amselgesang/weatherframe_v01/raw/images/hat-back-ruler.jpg

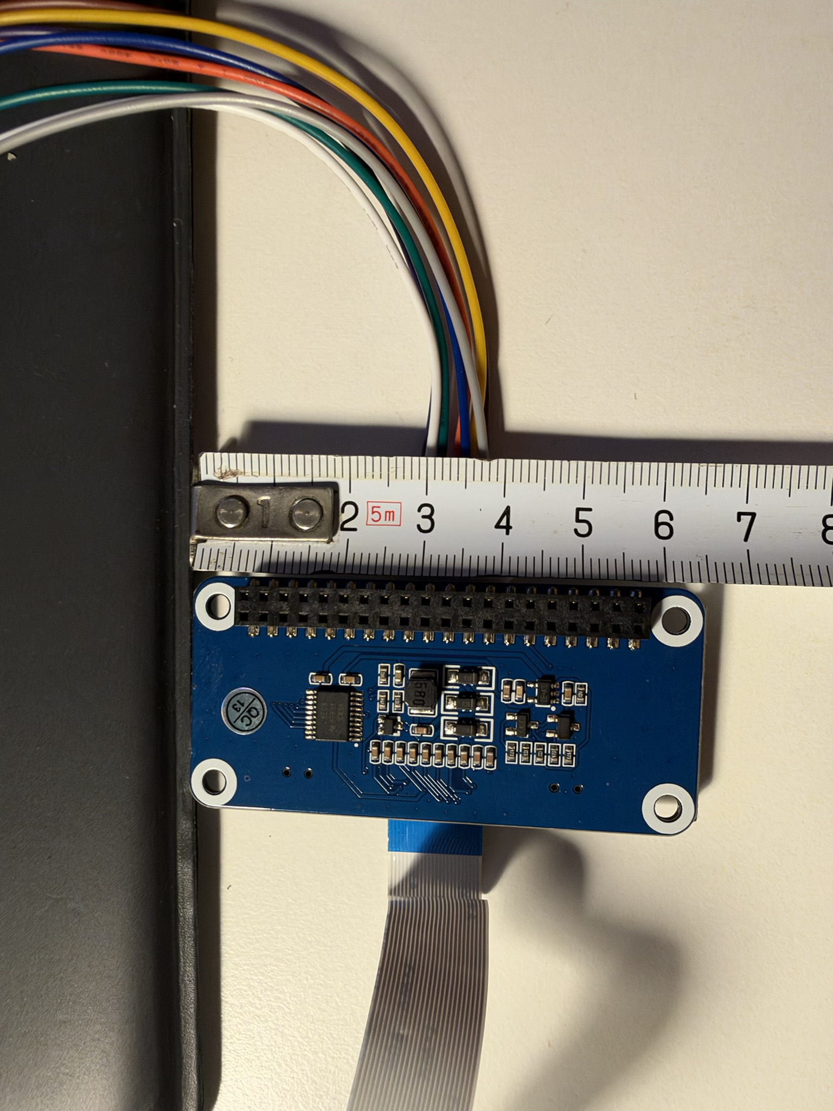
raw/images/hat-back-ruler.jpg
