amselgesang/weatherframe_v01/docs/images/weatherframe_cartoon.jpg

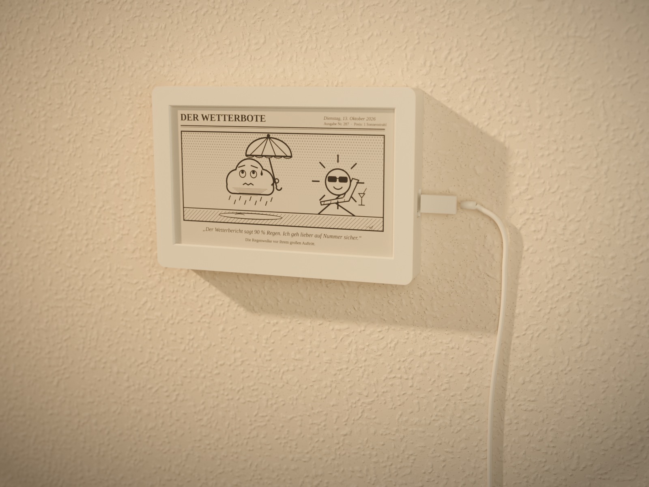
docs/images/weatherframe_cartoon.jpg
