amselgesang/weatherframe_v01/raw/README.md

# raw/ — immutable sources

Files here are kept exactly as received or clipped. The agent reads them and summarises them in
`wiki/sources/`, but never edits them. Add new material as new files.

| File | What | Date |
|---|---|---|
| `requirements-2026-10-13.md` | The project brief and later requirements, in the owner's words | 2026-10-13 |
| `images/hat-front.jpg`, `images/hat-back-ruler.jpg` | Photos of the Waveshare e-Paper Driver HAT Rev2.1, back side with a cm ruler | 2026-10-13 |
| `jlcpcb-assembly-message-2026-10-13.md` | JLCPCB's message refusing the ESP32 module in Economic assembly | 2026-10-13 |
| `seeed-gfx-epaper-board-pins.h` | Pin definitions for the XIAO ePaper boards, excerpt from Seeed_GFX (MIT) | 2026-10-13 |
| `waveshare-7in5-v2-mechanical.md` | Clipping of the panel's mechanical drawing (spec rev 2.0, section 1.4) | 2026-10-13 |
| `ti-tps63001-pins.md` | Clipping of the TPS63001 pin table used to verify the custom PCB | 2026-10-13 |
| `seeed-xiao-epaper-boards.md` | Clipping of Seeed's wiki pages for the EE04/EE05 boards | 2026-10-13 |
