amselgesang/weatherframe_v01/raw/requirements-2026-10-13.md

# Requirements as stated by the owner (verbatim, 2026-10-13)

> I would like to have a weather station using my waveshare 7.5 grayscale e-paper. I would like to use
> it as a picture frame on the wall. it connects to wifi but I would like to use it with chargeable
> battery. I need a design of the frame and the pcb as well. I have adobe fusion 365 for physical design
> and I have kicad for pcb design if needed. use them if possible

> also, eventually I want to use jclpcb to manufacture the pcb and the parts

> i would prefer a white frame color

> could the frame extended with a flip out stand so it can be also put to a cupboard
> → 25 degree and 3 mm gap

> can you engrave the text on the left side of those wholes. also make the hinge wider. it looks a bit unstable.
> use the right side of the whole for the refresh text

> can you make the stand wider

> unfortunatley I cannot solder  → chose: off-the-shelf ESP32 board
