amselgesang/weatherframe_v01/raw/waveshare-7in5-v2-mechanical.md

# Clipping: Waveshare 7.5inch e-Paper V2 Specification, rev 2.0 (2019-06-28), section 1.4

Source: https://files.waveshare.com/upload/6/60/7.5inch_e-Paper_V2_Specification.pdf (read 2026-10-13
through the Google Docs viewer; direct download was blocked by the network proxy).

- Outline 170.2 ± 0.2 × 111.2 ± 0.2 × 1.18 ± 0.1 mm; corners R1.
- Active area 163.2 ± 0.1 × 97.92 ± 0.1 mm; 800 × 480 px, 125 dpi, pixel 0.204 × 0.205 mm.
- Layer steps horizontal: AA 163.2 → FPL 164.8 → PS 167.8 → outline 170.2 (0.8 / 1.5 / 1.2 mm per side).
- Layer steps vertical: AA 97.92 → FPL 104.09 → PS 107.09 → outline 111.2.
- FPC: 24 pins, 0.5 mm pitch, 22.04 ± 0.1 mm wide, tail 24 ± 0.2 mm, leaves the long edge.
- Unlabelled tolerances ±0.15 mm.
- Grayscale: 4 levels (4-grey refresh about 2.1 s, from the Waveshare wiki); controller UC8179.
