amselgesang/weatherframe_v01/wiki/sources/requirements-2026-10-13.md

---
title: Owner requirements (2026-10-13)
type: source-summary
sources:
  - raw/requirements-2026-10-13.md
related:
  - "[[overview]]"
  - "[[flip-out-stand]]"
  - "[[no-solder-build]]"
created: 2026-10-13
updated: 2026-10-13
confidence: high
---
# Owner requirements (2026-10-13)

Weather station on the owner's [[waveshare-7in5-v2-panel]], used as a wall picture frame, Wi-Fi,
rechargeable battery; frame and PCB to be designed, in Fusion 360 and KiCad where possible; made by
[[jlcpcb]]. Later: white frame, [[flip-out-stand]] at 25° with a 3 mm wall gap, engraved button labels,
wider hinge and stand, and no soldering ([[no-solder-build]]).
