amselgesang/weatherframe_v01/wiki/sources/seeed-gfx-epaper-board-pins.md

---
title: Seeed_GFX board pin definitions
type: source-summary
sources:
  - raw/seeed-gfx-epaper-board-pins.h
related:
  - "[[seeed-ee05]]"
  - "[[esphome-firmware]]"
created: 2026-10-13
updated: 2026-10-13
confidence: high
---
# Seeed_GFX board pin definitions

`User_Setups/EPaper_Board_Pins_Setups.h` from Seeed_GFX (MIT): SPI, CS, DC, BUSY, RST and
`TFT_ENABLE` (panel power, GPIO43, driven HIGH) for the EE02–EE05 and EN04/EN05 boards. Authoritative
source for the [[seeed-ee05]] panel pins in the [[esphome-firmware]].
