amselgesang/weatherframe_v01/wiki/sources/seeed-xiao-epaper-boards.md

---
title: Seeed XIAO ePaper board docs
type: source-summary
sources:
  - raw/seeed-xiao-epaper-boards.md
related:
  - "[[seeed-ee05]]"
  - "[[custom-pcb-vs-ee05]]"
created: 2026-10-13
updated: 2026-10-13
confidence: medium
---
# Seeed XIAO ePaper board docs

Wiki and shop pages for EE04/EE05/EN04/EN05 and the ESPHome cookbook: board features, supported
panels, EE04 battery and key pins, ESPHome display pins. Basis for choosing the [[seeed-ee05]];
EN0x boards ruled out (no Wi-Fi). Battery/key pins for the EE05 itself are not documented
(confidence medium).
