amselgesang/weatherframe_v01/wiki/sources/waveshare-7in5-v2-mechanical.md

---
title: Waveshare 7.5" V2 mechanical drawing
type: source-summary
sources:
  - raw/waveshare-7in5-v2-mechanical.md
related:
  - "[[waveshare-7in5-v2-panel]]"
  - "[[frame]]"
created: 2026-10-13
updated: 2026-10-13
confidence: high
---
# Waveshare 7.5" V2 mechanical drawing

Outline, active area, layer steps and FPC data for the [[waveshare-7in5-v2-panel]]; the basis for the
window, recess and ribbon routing of the [[frame]].
