amselgesang/weatherframe_v01/wiki/entities/jlcpcb.md

---
title: JLCPCB / JLC3DP
type: entity
sources:
  - raw/jlcpcb-assembly-message-2026-10-13.md
related:
  - "[[jlc-assembly-tiers]]"
  - "[[frame]]"
created: 2026-10-13
updated: 2026-10-13
confidence: high
---
# JLCPCB / JLC3DP

Manufacturer chosen by the owner. PCB fabrication + SMT assembly (JLCPCB) and 3D printing (JLC3DP).
Assembly tiers matter: see [[jlc-assembly-tiers]]. Current plan: only the [[frame]] is ordered here
(MJF PA12 or SLA 9000R, white); electronics are bought ready-made ([[seeed-ee05]]).

Sources: [[jlcpcb-assembly-message]]
