amselgesang/weatherframe_v01/wiki/sources/hat-photos.md

---
title: HAT photos with ruler
type: source-summary
sources:
  - raw/images/hat-front.jpg
  - raw/images/hat-back-ruler.jpg
related:
  - "[[waveshare-epaper-driver-hat]]"
  - "[[frame]]"
created: 2026-10-13
updated: 2026-10-13
confidence: high
---
# HAT photos with ruler

Two photos of the [[waveshare-epaper-driver-hat]] Rev2.1: front (labels, switches, ZIF, JST PH) and
back with a cm ruler (65 mm width, 40-pin header along the edge opposite the ribbon, four mounting holes).
Used to replace the assumed HAT mount with four standoffs in the [[frame]].
