amselgesang/weatherframe_v01/wiki/sources/ti-tps63001-pins.md

---
title: TI TPS63001 pin table
type: source-summary
sources:
  - raw/ti-tps63001-pins.md
related:
  - "[[custom-pcb-r1]]"
created: 2026-10-13
updated: 2026-10-13
confidence: high
---
# TI TPS63001 pin table

Used to verify the buck-boost wiring of the [[custom-pcb-r1]]: FB must go to VOUT on fixed versions,
PS/SYNC low enables power-save mode. All ten pins matched.
