amselgesang/weatherframe_v01/docs/images/screen_cartoon.png

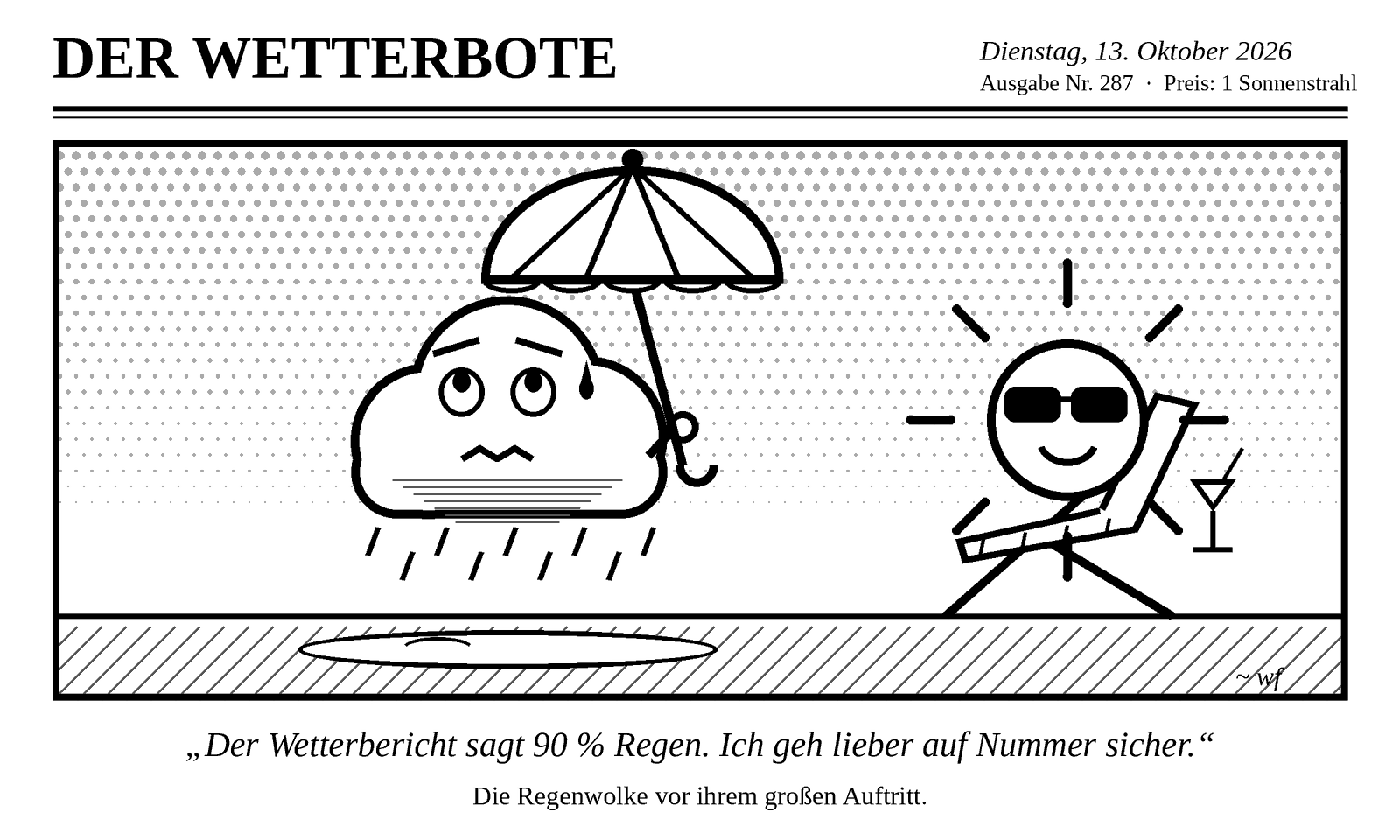
docs/images/screen_cartoon.png
