amselgesang/weatherframe_v01/docs/images/screen_forecast.png

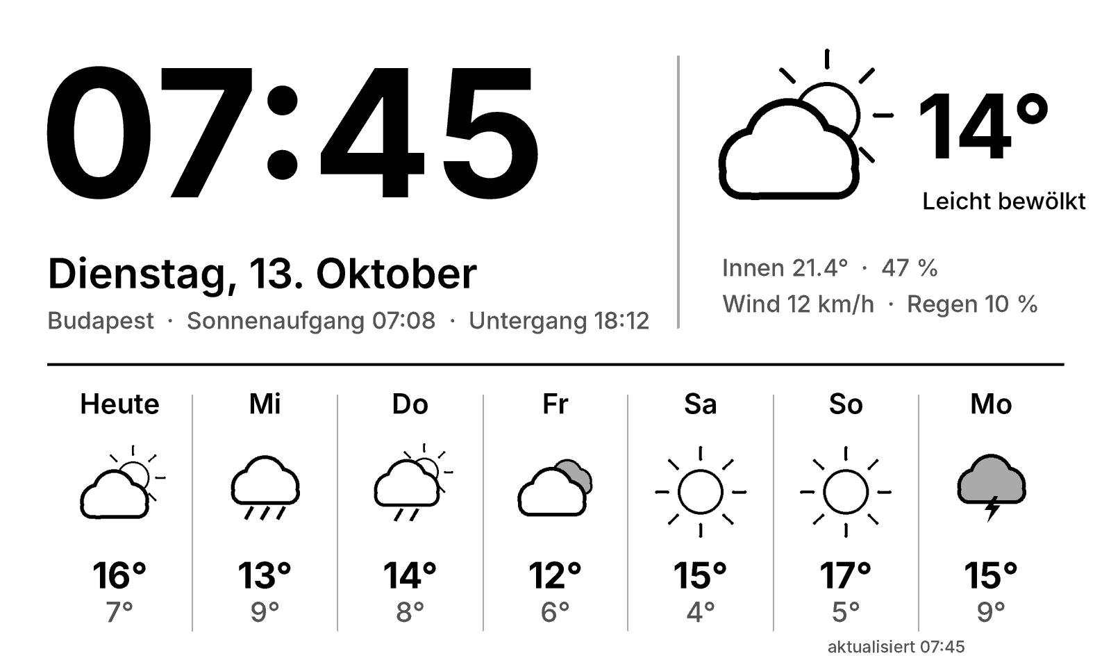
docs/images/screen_forecast.png
