amselgesang/weatherframe_v01/hardware/mechanical/export/view_bezel_inside.png

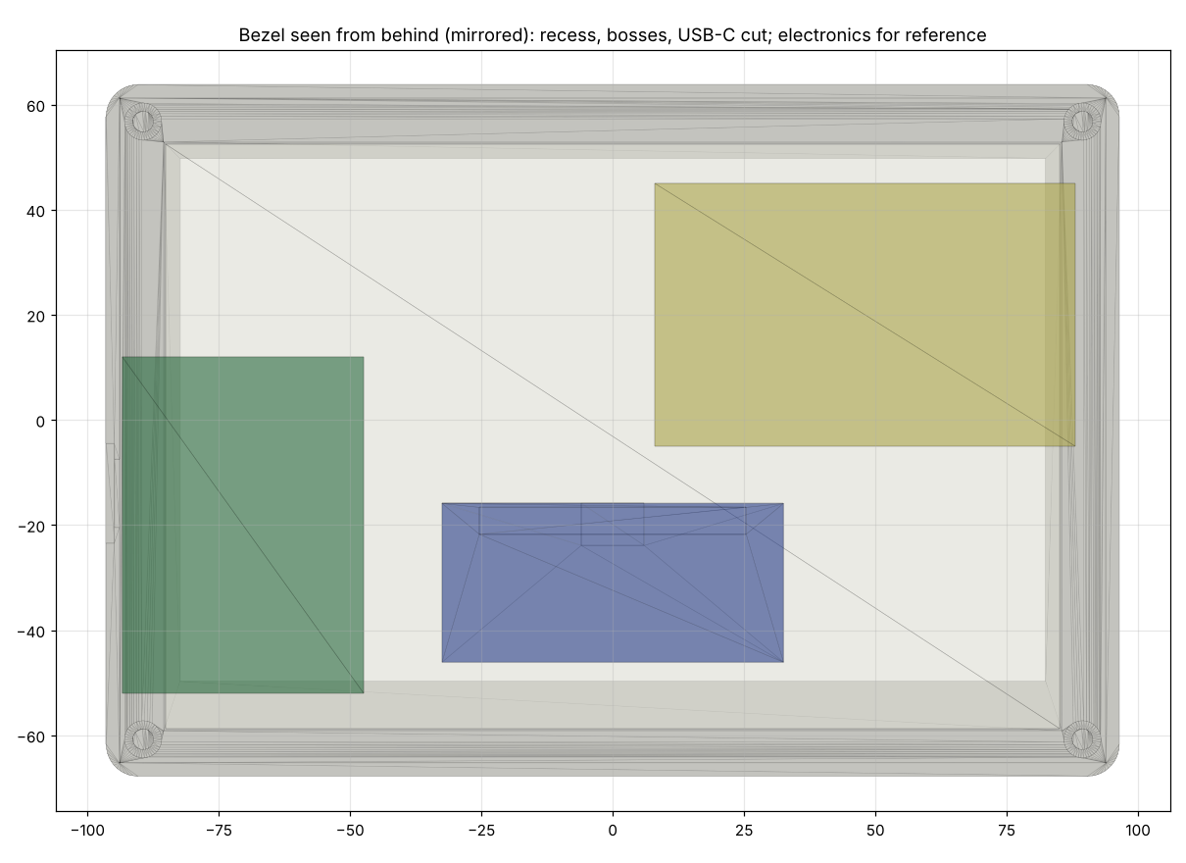
hardware/mechanical/export/view_bezel_inside.png
