amselgesang/weatherframe_v01/hardware/mechanical/export/view_front.png

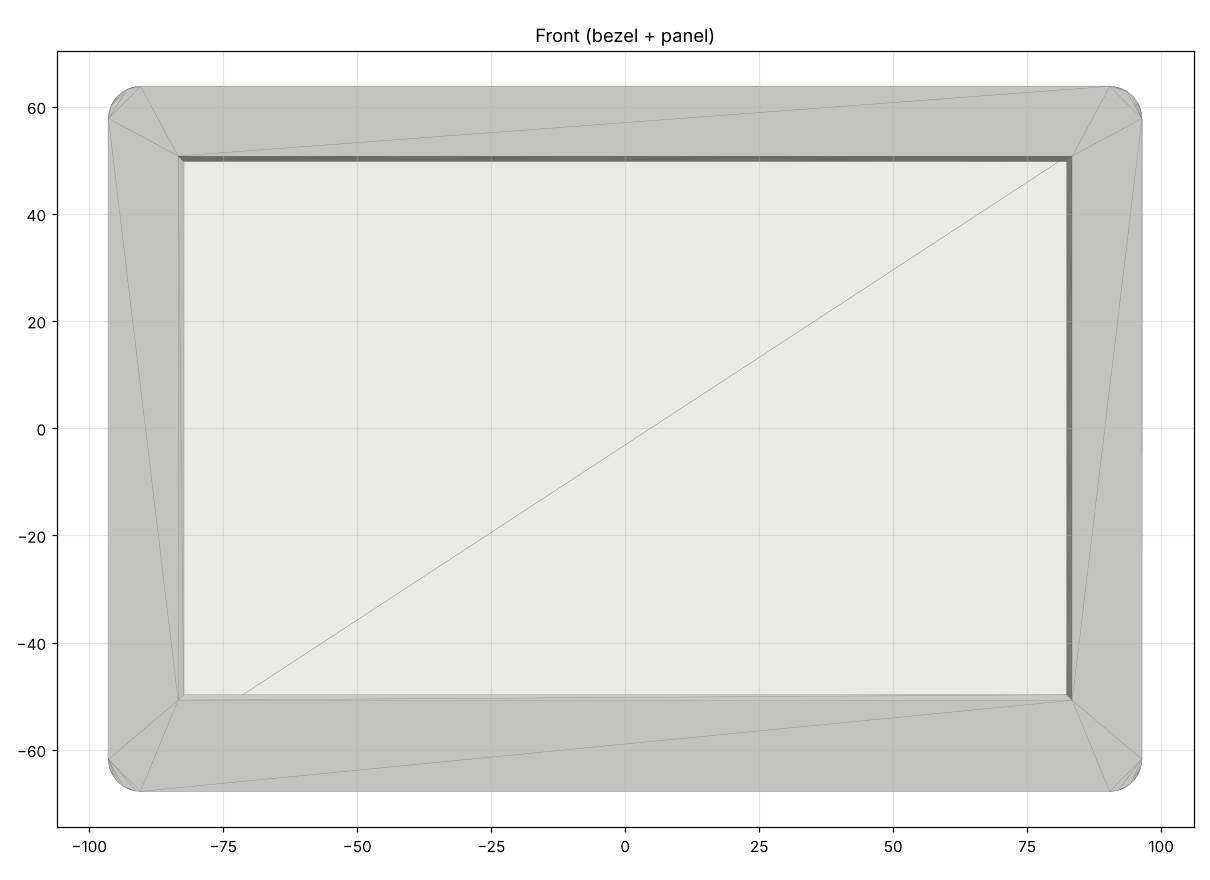
hardware/mechanical/export/view_front.png
