amselgesang/weatherframe_v01/hardware/mechanical/export/view_inside_back.png

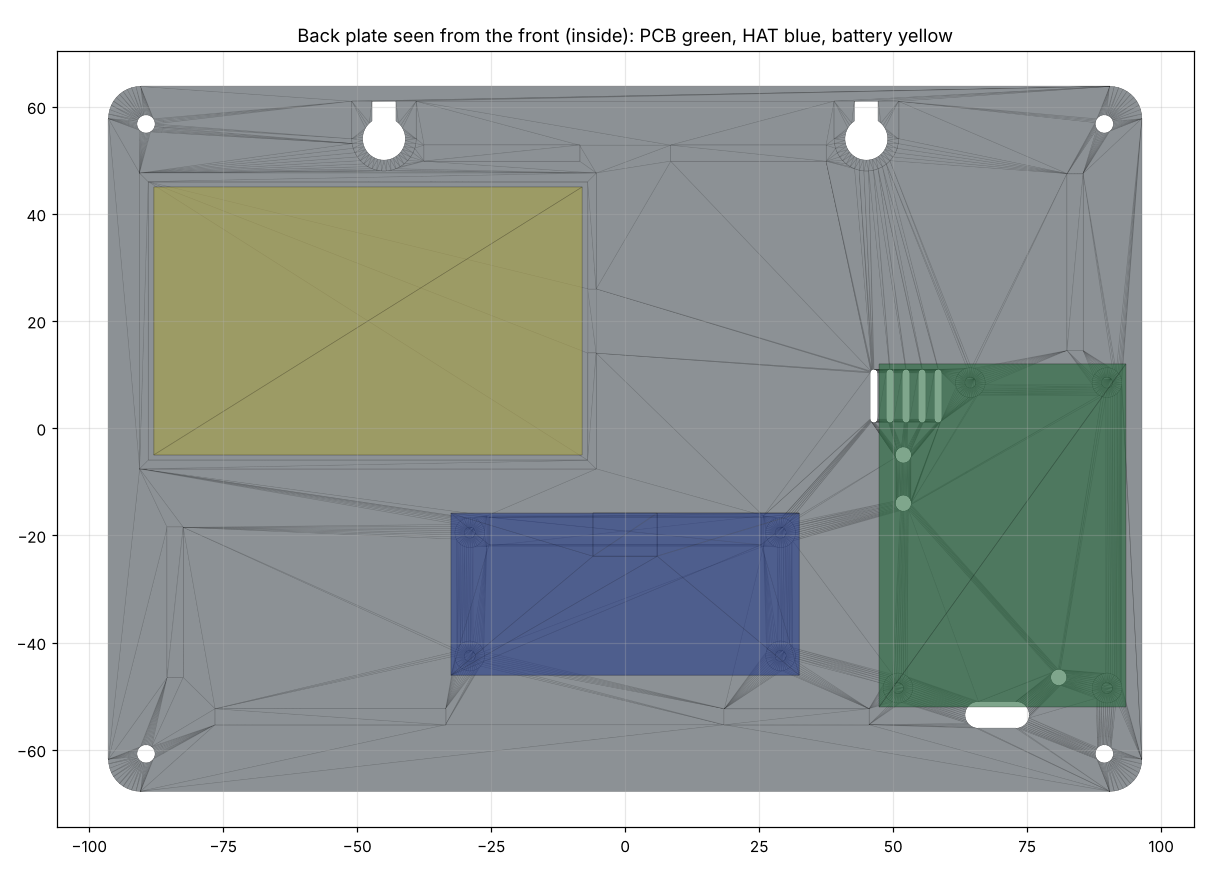
hardware/mechanical/export/view_inside_back.png
