amselgesang/weatherframe_v01/hardware/mechanical/export/view_rear.png

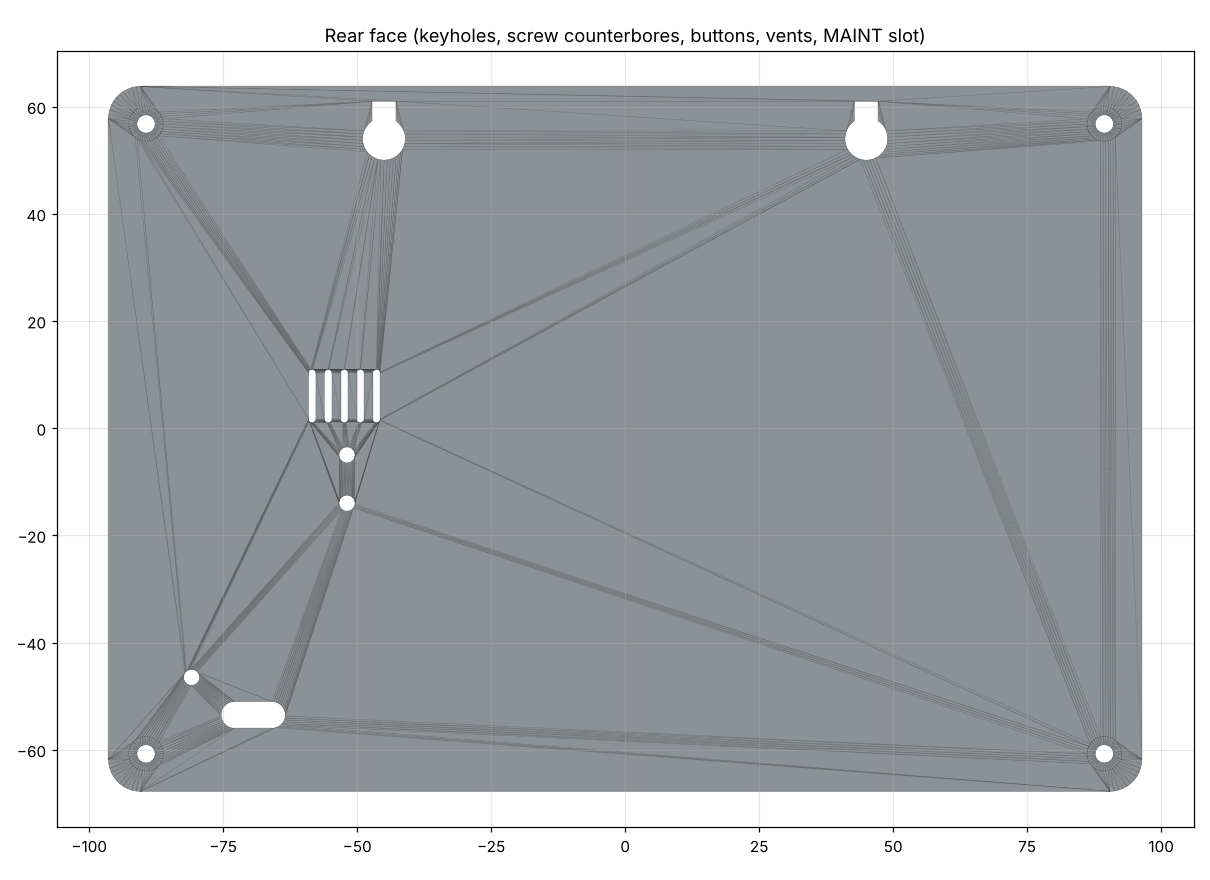
hardware/mechanical/export/view_rear.png
