amselgesang/weatherframe_v01/raw/images/hat-front.jpg

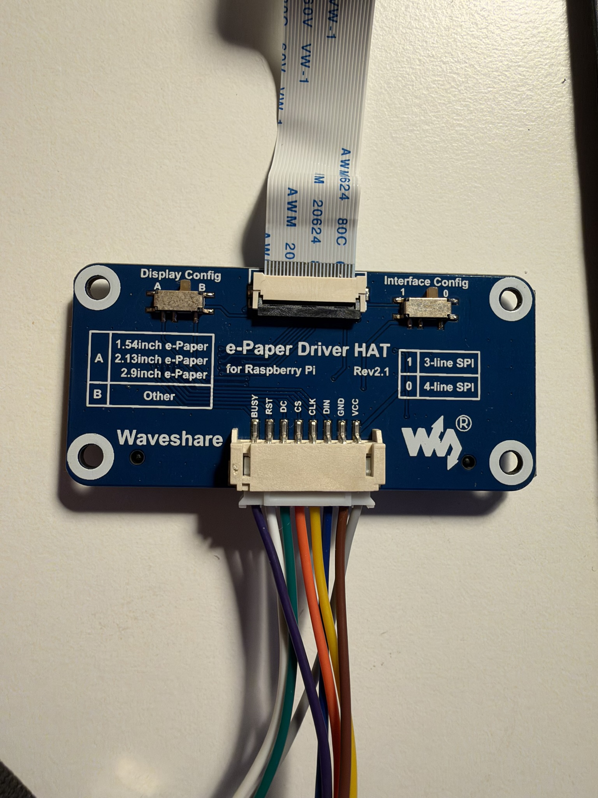
raw/images/hat-front.jpg
