amselgesang/weatherframe_v01/hardware/kicad/weatherframe/fab/bom_jlc.csv

Comment | Designator | Footprint | LCSC Part #
USB-C | J1 | USB_C_Receptacle_HRO_TYPE-C-31-M-12 | C165948
5.1k | R1,R2 | R_0402_1005Metric | C25905
USBLC6-2SC6 | U5 | SOT-23-6 | C7519
MCP73831-2 | U2 | SOT-23-5 | C424093
4.7uF | C1,C2,C13 | C_0603_1608Metric | C19666
2k | R3 | R_0402_1005Metric | C4109
1k | R4 | R_0402_1005Metric | C11702
CHG | D2 | LED_0603_1608Metric | C2286
100k | R5,R10,R17 | R_0402_1005Metric | C25741
150k | R6,R11 | R_0402_1005Metric | C25755
LiPo 1S | J2 | JST_PH_S2B-PH-SM4-TB_1x02-1MP_P2.00mm_Horizontal | C2763693
B5819W | D1 | D_SOD-123 | C8598
AO3401A | Q1,Q2 | SOT-23 | C15127
1M | R8,R9 | R_0402_1005Metric | C26083
100nF | C3,C5,C9,C11,C12 | C_0402_1005Metric | C1525
TPS63001 | U3 | Texas_DRC0010J | C28060
1.5uH | L1 | L_Changjiang_FNR4030S | C42100
10uF | C4 | C_0805_2012Metric | C15850
22uF | C6,C7 | C_0805_2012Metric | C45783
ESP32-S3-WROOM-1-N16R8 | U1 | ESP32-S3-WROOM-1 | C2913202
10uF | C8 | C_0603_1608Metric | C19702
10k | R12,R13,R14 | R_0402_1005Metric | C25744
1uF | C10 | C_0402_1005Metric | C52923
RESET | SW1 | SW_Push_1P1T_XKB_TS-1187A | C318884
BOOT | SW2 | SW_Push_1P1T_XKB_TS-1187A | C318884
REFRESH | SW3 | SW_Push_1P1T_XKB_TS-1187A | C318884
MAINT | SW4 | SW_SPDT_Shouhan_MSK12C02 | C431540
SHT40-AD1B | U4 | Sensirion_DFN-4_1.5x1.5mm_P0.8mm_SHT4x_NoCentralPad | C2909890
4.7k | R15,R16 | R_0402_1005Metric | C25900
