amselgesang/weatherframe_v01/hardware/mechanical/export/weatherframe_assembly.step

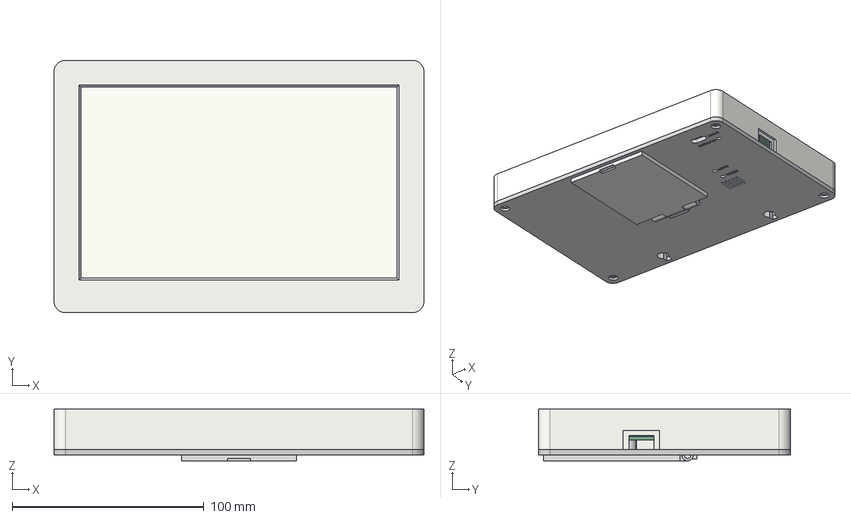
[picture p10: CAD file, 2026-10-13]
hardware/mechanical/export/weatherframe_assembly.step
192.8 x 131.5 x 27.0 mm
bezel
back
stand
ref_panel
ref_pcb
ref_hat
ref_battery
