amselgesang/weatherframe_v01/hardware/mechanical/export/back.step

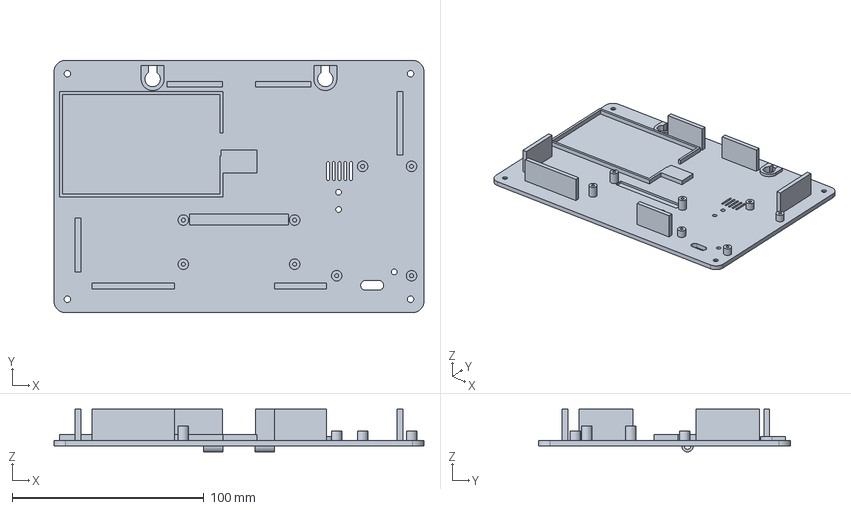
[picture p11: CAD file, 2026-10-13]
hardware/mechanical/export/back.step
192.8 x 131.5 x 22.3 mm
