amselgesang/weatherframe_v01/hardware/mechanical/export/bezel.step

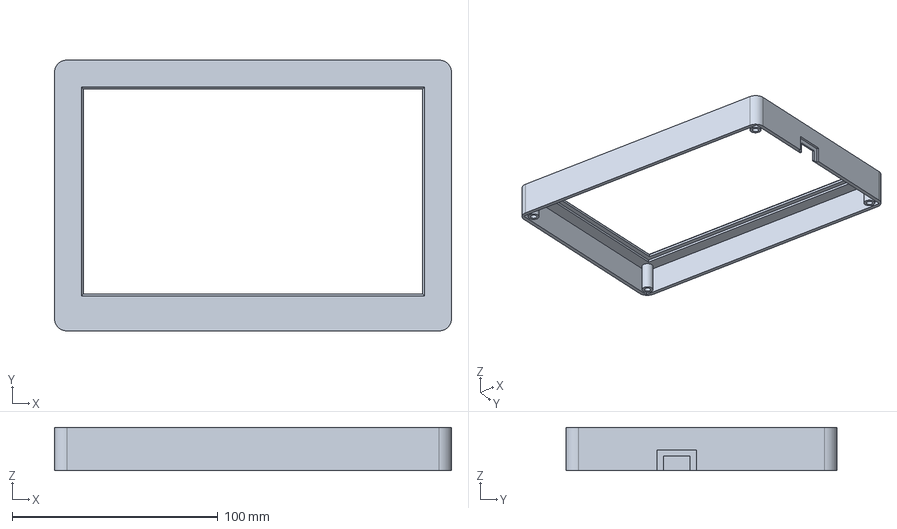
[picture p12: CAD file, 2026-10-13]
hardware/mechanical/export/bezel.step
192.8 x 131.5 x 21.0 mm
