amselgesang/weatherframe_v01/hardware/mechanical/export/stand.step

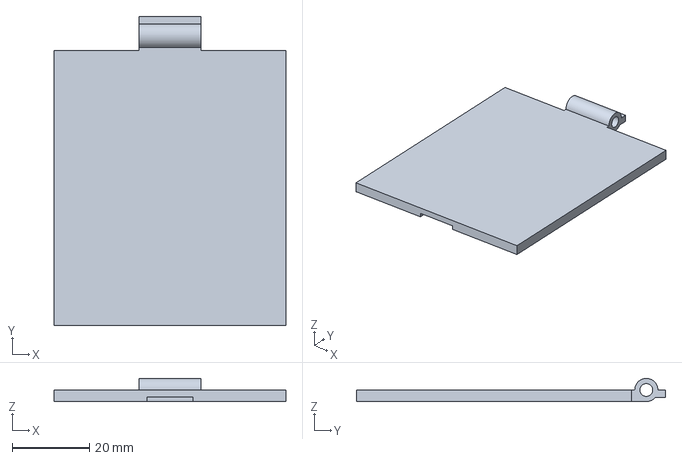
[picture p13: CAD file, 2026-10-13]
hardware/mechanical/export/stand.step
60.0 x 80.0 x 6.00 mm
