amselgesang/weatherframe_v01/(list of files, cad)

Other CAD files:
hardware/mechanical/export/back.stl
hardware/mechanical/export/bezel.stl
hardware/mechanical/export/stand.stl
