amselgesang/weatherframe_v01/raw/jlcpcb-assembly-message-2026-10-13.md

# JLCPCB assembly message for U1 (ESP32-S3-WROOM-1-N16R8), received 2026-10-13 (verbatim)

> Due to limits in package (0201), temperature and other certain conditions, this part is only available
> for Standard PCBA service. Economic PCBA has been chosen. If you want to place this part, please switch
> to the Standard PCBA.
> Note: The setup fee is $25 per assembly side for Standard PCBA.
> The board size is modified to be 74mm*70mm as for Standard PCBA each side should be longer than 70mm and
> the edge rails should be added.
