amselgesang/weatherframe_v01/wiki/sources/jlcpcb-assembly-message.md

---
title: JLCPCB assembly message
type: source-summary
sources:
  - raw/jlcpcb-assembly-message-2026-10-13.md
related:
  - "[[jlc-assembly-tiers]]"
  - "[[custom-pcb-vs-ee05]]"
created: 2026-10-13
updated: 2026-10-13
confidence: high
---
# JLCPCB assembly message

JLCPCB refused U1 (ESP32-S3-WROOM-1) in Economic assembly and proposed Standard assembly ($25 setup,
board enlarged to 74 × 70 mm with rails). Triggered [[custom-pcb-vs-ee05]]; background in
[[jlc-assembly-tiers]].
