amselgesang/weatherframe_v01/hardware/kicad/weatherframe/build/bcu.svg.png

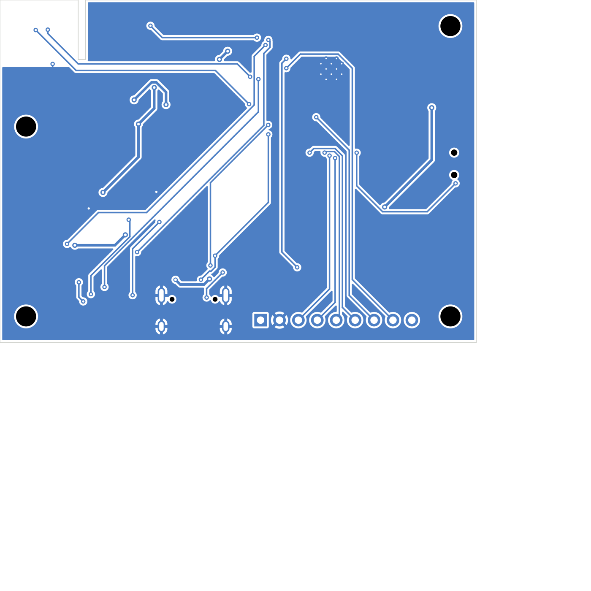
hardware/kicad/weatherframe/build/bcu.svg.png
