amselgesang/weatherframe_v01/hardware/kicad/weatherframe/build/fcu.svg.png

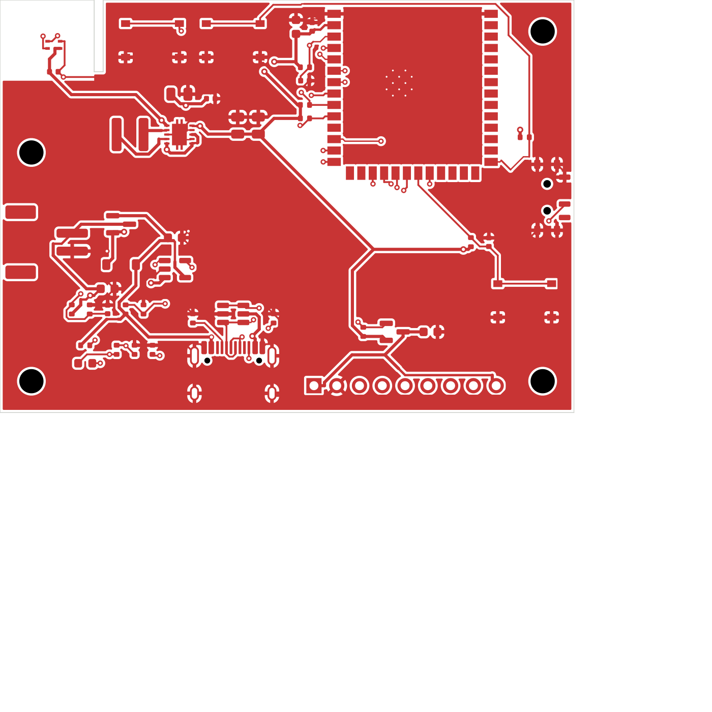
hardware/kicad/weatherframe/build/fcu.svg.png
