amselgesang/weatherframe_v01/hardware/kicad/weatherframe/build/placed.svg.png

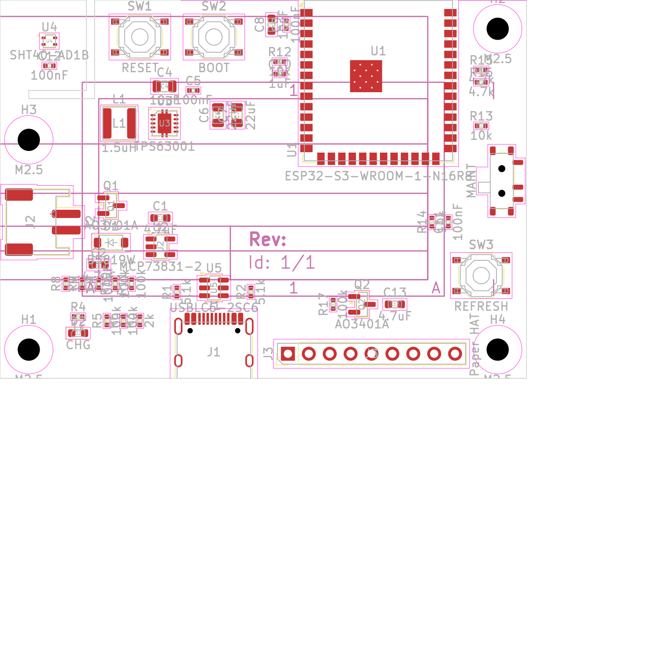
hardware/kicad/weatherframe/build/placed.svg.png
