amselgesang/weatherframe_v01/hardware/kicad/weatherframe/build/render_top.png

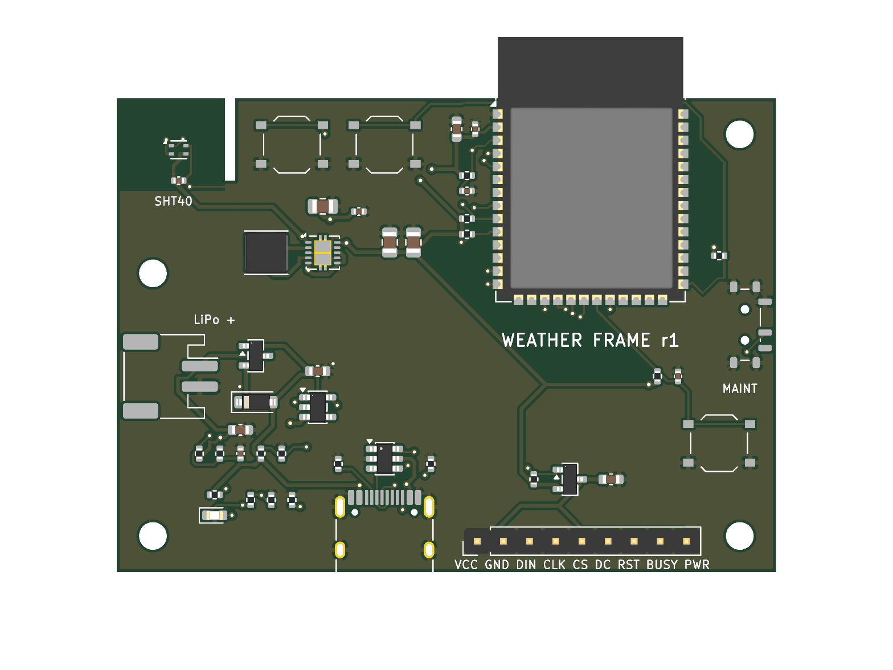
hardware/kicad/weatherframe/build/render_top.png
