amselgesang/weatherframe_v01/hardware/kicad/weatherframe/build/routed.svg.png

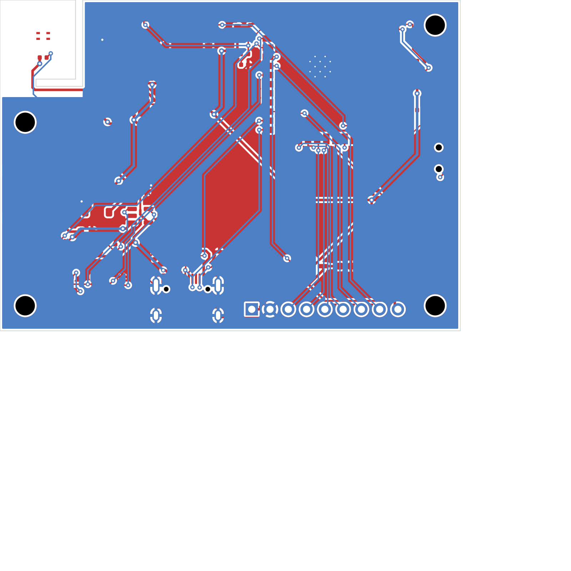
hardware/kicad/weatherframe/build/routed.svg.png
