amselgesang/weatherframe_v01/(list of files, drawings)

Other design files:
hardware/kicad/weatherframe/build/weatherframe.dsn
