amselgesang/weatherframe_v01/hardware/kicad/weatherframe/weatherframe.kicad_pcb

## KiCad design hardware/kicad/weatherframe/weatherframe.kicad_pcb (2026-10-13)

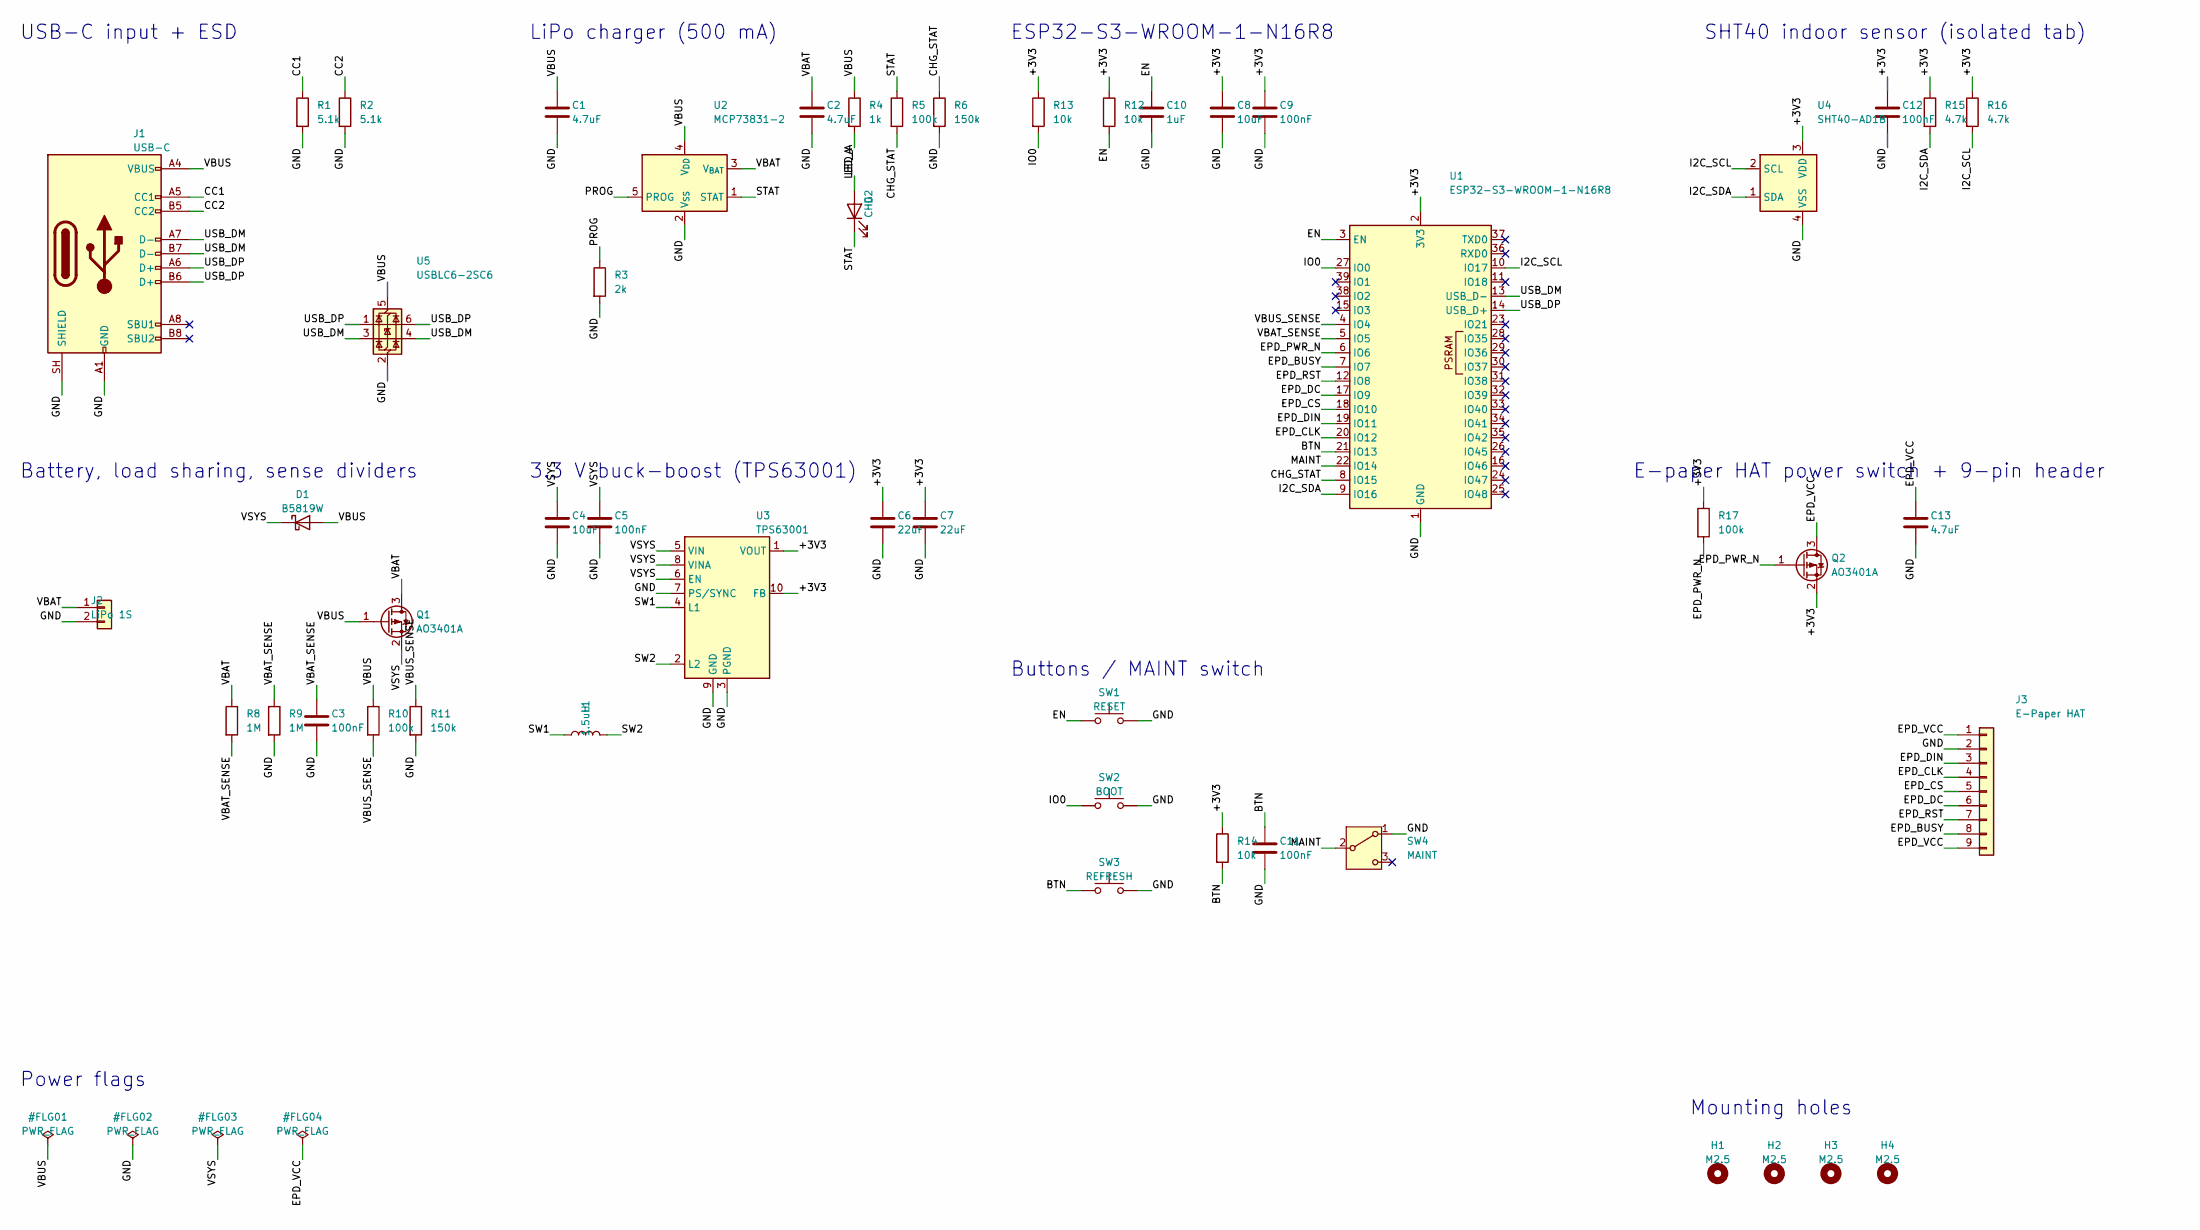
[picture p19: schematic weatherframe.kicad_sch, E-Paper Weather Frame - main board]

Parts:
C1, C2, C13: 4.7uF; C_0603_1608Metric; MPN 4.7uF; LCSC C19666
C3, C5, C9, C11, C12: 100nF; C_0402_1005Metric; MPN 100nF; LCSC C1525
C4: 10uF; C_0805_2012Metric; MPN 10uF; LCSC C15850
C6, C7: 22uF; C_0805_2012Metric; MPN 22uF; LCSC C45783
C8: 10uF; C_0603_1608Metric; MPN 10uF; LCSC C19702
C10: 1uF; C_0402_1005Metric; MPN 1uF; LCSC C52923
D1: B5819W; D_SOD-123; MPN B5819W; LCSC C8598
D2: CHG; LED_0603_1608Metric; MPN KT-0603R; LCSC C2286
H1, H2, H3, H4: M2.5; MountingHole_2.7mm_M2.5; MPN M2.5
J1: USB-C; USB_C_Receptacle_HRO_TYPE-C-31-M-12; MPN TYPE-C-31-M-12; LCSC C165948
J2: LiPo 1S; JST_PH_S2B-PH-SM4-TB_1x02-1MP_P2.00mm_Horizontal; MPN PH-2AWT (JST PH 2.0); LCSC C2763693
J3: E-Paper HAT; PinHeader_1x09_P2.54mm_Vertical; MPN 1x9 pin header 2.54 mm (hand-solder)
L1: 1.5uH; L_Changjiang_FNR4030S; MPN SWPA4030S1R5NT; LCSC C42100
Q1, Q2: AO3401A; SOT-23; MPN AO3401A; LCSC C15127
R1, R2: 5.1k; R_0402_1005Metric; MPN 5.1k; LCSC C25905
R3: 2k; R_0402_1005Metric; MPN 2k; LCSC C4109
R4: 1k; R_0402_1005Metric; MPN 1k; LCSC C11702
R5, R10, R17: 100k; R_0402_1005Metric; MPN 100k; LCSC C25741
R6, R11: 150k; R_0402_1005Metric; MPN 100k; LCSC C25755
R8, R9: 1M; R_0402_1005Metric; MPN 1M; LCSC C26083
R12, R13, R14: 10k; R_0402_1005Metric; MPN 10k; LCSC C25744
R15, R16: 4.7k; R_0402_1005Metric; MPN 4.7k; LCSC C25900
SW1: RESET; SW_Push_1P1T_XKB_TS-1187A; MPN TS-1187A-B-A-B; LCSC C318884
SW2: BOOT; SW_Push_1P1T_XKB_TS-1187A; MPN TS-1187A-B-A-B; LCSC C318884
SW3: REFRESH; SW_Push_1P1T_XKB_TS-1187A; MPN TS-1187A-B-A-B; LCSC C318884
SW4: MAINT; SW_SPDT_Shouhan_MSK12C02; MPN MSK12C02; LCSC C431540
U1: ESP32-S3-WROOM-1-N16R8; ESP32-S3-WROOM-1; MPN ESP32-S3-WROOM-1-N16R8; LCSC C2913202
U2: MCP73831-2; SOT-23-5; MPN MCP73831T-2ACI/OT; LCSC C424093
U3: TPS63001; Texas_DRC0010J; MPN TPS63001DRCR; LCSC C28060
U4: SHT40-AD1B; Sensirion_DFN-4_1.5x1.5mm_P0.8mm_SHT4x_NoCentralPad; MPN SHT40-AD1B-R2; LCSC C2909890
U5: USBLC6-2SC6; SOT-23-6; MPN USBLC6-2SC6; LCSC C7519

Connections:
+3V3: C6.1, C7.1, C8.1, C9.1, C12.1, Q2.2 (S), R12.1, R13.1, R14.1, R15.1, R16.1, R17.1, U1.2 (3V3), U3.1 (VOUT), U3.10 (FB), U4.3 (VDD)
BTN: C11.1, R14.2, SW3.1, U1.21 (IO13)
CC1: J1.A5 (CC1), R1.1
CC2: J1.B5 (CC2), R2.1
CHG_STAT: R5.2, R6.1, U1.8 (IO15)
EN: C10.1, R12.2, SW1.1, U1.3 (EN)
EPD_BUSY: J3.8, U1.7 (IO7)
EPD_CLK: J3.4, U1.20 (IO12)
EPD_CS: J3.5, U1.18 (IO10)
EPD_DC: J3.6, U1.17 (IO9)
EPD_DIN: J3.3, U1.19 (IO11)
EPD_PWR_N: Q2.1 (G), R17.2, U1.6 (IO6)
EPD_RST: J3.7, U1.12 (IO8)
EPD_VCC: C13.1, J3.1, J3.9, Q2.3 (D)
GND: C1.2, C2.2, C3.2, C4.2, C5.2, C6.2, C7.2, C8.2, C9.2, C10.2, C11.2, C12.2, C13.2, J1.A1 (GND), J1.A12 (GND), J1.B1 (GND), J1.B12 (GND), J1.SH (SHIELD), J2.2, J3.2, R1.2, R2.2, R3.2, R6.2, R9.2, R11.2, SW1.2, SW2.2, SW3.2, SW4.1 (A), SW4.SH, U1.1 (GND), U1.40 (GND), U1.41 (GND), U2.2 (V_{SS}), U3.3 (PGND), U3.7 (PS/SYNC), U3.9 (GND), U3.11 (PGND), U4.4 (VSS), U5.2 (GND)
I2C_SCL: R16.2, U1.10 (IO17), U4.2 (SCL)
I2C_SDA: R15.2, U1.9 (IO16), U4.1 (SDA)
IO0: R13.2, SW2.1, U1.27 (IO0)
LED_A: D2.2 (A), R4.2
MAINT: SW4.2 (B), U1.22 (IO14)
PROG: R3.1, U2.5 (PROG)
STAT: D2.1 (K), R5.1, U2.1 (STAT)
SW1: L1.1, U3.4 (L1)
SW2: L1.2, U3.2 (L2)
USB_DM: J1.A7 (D-), J1.B7 (D-), U1.13 (USB_D-), U5.3 (I/O2), U5.4 (I/O2)
USB_DP: J1.A6 (D+), J1.B6 (D+), U1.14 (USB_D+), U5.1 (I/O1), U5.6 (I/O1)
VBAT: C2.1, J2.1, Q1.3 (D), R8.1, U2.3 (V_{BAT})
VBAT_SENSE: C3.1, R8.2, R9.1, U1.5 (IO5)
VBUS: C1.1, D1.2 (A), J1.A4 (VBUS), J1.A9 (VBUS), J1.B4 (VBUS), J1.B9 (VBUS), Q1.1 (G), R4.1, R10.1, U2.4 (V_{DD}), U5.5 (VBUS)
VBUS_SENSE: R10.2, R11.1, U1.4 (IO4)
VSYS: C4.1, C5.1, D1.1 (K), Q1.2 (S), U3.5 (VIN), U3.6 (EN), U3.8 (VINA)

Notes on the sheet:
USB-C input + ESD
LiPo charger (500 mA)
Battery, load sharing, sense dividers
3.3 V buck-boost (TPS63001)
ESP32-S3-WROOM-1-N16R8
Buttons / MAINT switch
SHT40 indoor sensor (isolated tab)
E-paper HAT power switch + 9-pin header
Mounting holes
Power flags

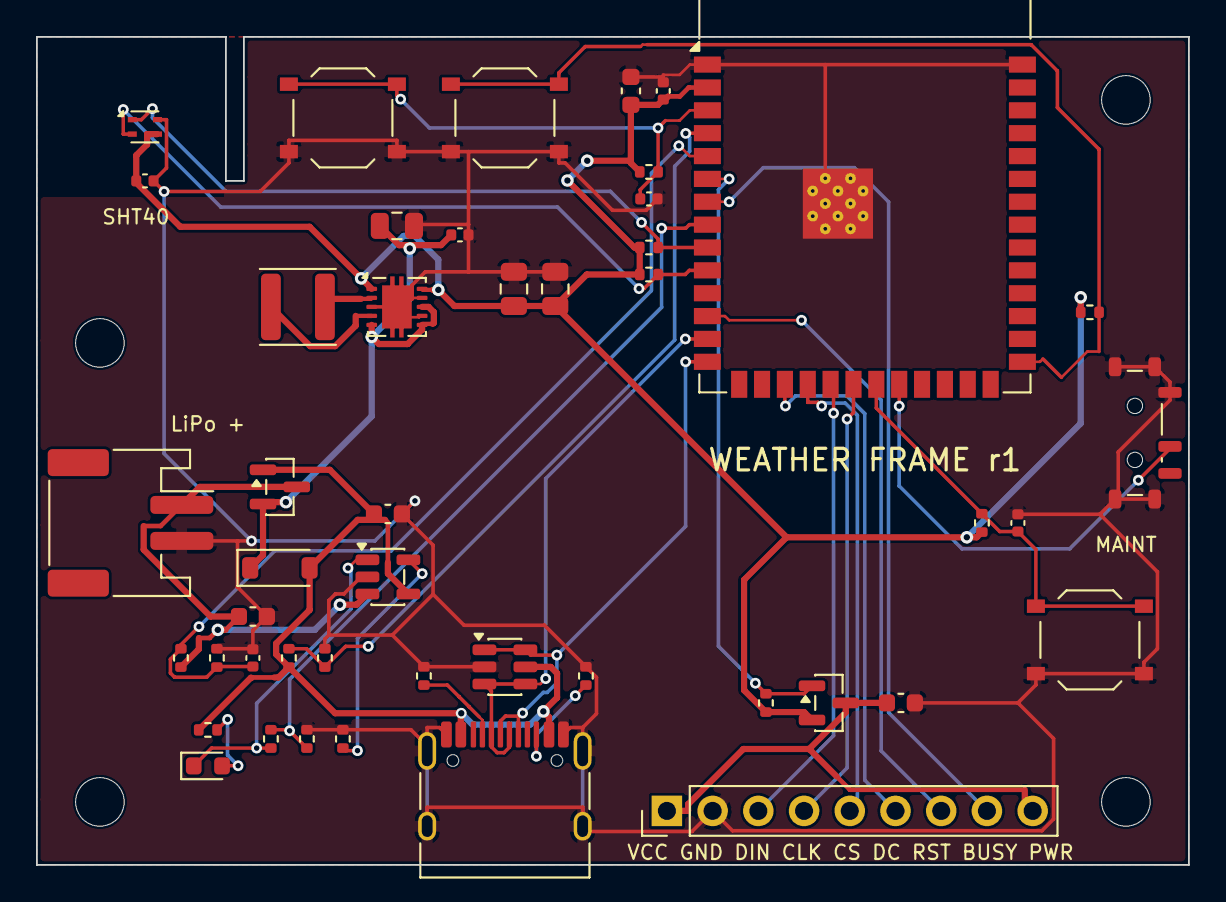
[picture p20: board weatherframe.kicad_pcb from above]

Board: 2 copper layers, 64.0 x 46.0 mm, 50 parts (0 on the bottom side), 31 nets.
